bnvac/radio-thing/hardware/bom.csv

Refs | Value | Footprint | Variant | Note | Qty | DNP
BZ1 | 3V magnetic transducer ~3 kHz | Buzzer_Beeper:MagneticBuzzer_Kingstate_KCG0601 | DISP | external-drive coil (~8.5 ohm), 2-4 V, <=150 mA mean: drive with ~2.7-3 kHz square wave | 1
C1 | 1u | Capacitor_SMD:C_0603_1608Metric | BOTH |  | 1
C2,C4 | 4.7u | Capacitor_SMD:C_0603_1608Metric | BOTH |  | 2
C3,C8,C9,C16 | 22u | Capacitor_SMD:C_0805_2012Metric | BOTH |  | 4
C5,C7,C17,C18,C19,C21 | 100n | Capacitor_SMD:C_0402_1005Metric | BOTH | MAX17048 VDD bypass 0.1 uF per datasheet,VINA filter cap | 6
C6 | 10u | Capacitor_SMD:C_0805_2012Metric | BOTH |  | 1
C10 | 10u | Capacitor_SMD:C_0805_2012Metric | POD |  | 1
C11 | 22u | Capacitor_SMD:C_0805_2012Metric | POD | DS min ~5*L uF = 11 uF before DC-bias derating | 1
C12,C14,C24 | 100n | Capacitor_SMD:C_0402_1005Metric | POD |  | 3
C13 | 47u | Capacitor_SMD:C_1206_3216Metric | POD |  | 1
C15 | 1u | Capacitor_SMD:C_0402_1005Metric | BOTH | EN RC delay | 1
C20 | 220n | Capacitor_SMD:C_0402_1005Metric | BOTH | LIS2MDL C1 = 220 nF, low ESR, right at pins 5/6 (DS Table 2) | 1
C25 | 10u | Capacitor_SMD:C_0603_1608Metric | BOTH | LIS2MDL recommends 100 nF + 10 uF on Vdd | 1
D1 | BAT54 | Diode_SMD:D_SOD-123 | DISP | flyback across the coil | 1
D2 | RED | LED_SMD:LED_0603_1608Metric | BOTH |  | 1
D3 | GREEN | LED_SMD:LED_0603_1608Metric | BOTH |  | 1
D4 | BLUE | LED_SMD:LED_0603_1608Metric | BOTH |  | 1
F1 | 1.5A hold | Fuse:Fuse_1206_3216Metric | BOTH |  | 1
FB1 | 600R@100MHz 1A | Inductor_SMD:L_0805_2012Metric | POD | LC filter: keep boost ripple out of the radar | 1
J1 | USB-C | Connector_USB:USB_C_Receptacle_HRO_TYPE-C-31-M-12 | BOTH |  | 1
J2 | LiPo 1S | Connector_JST:JST_PH_S2B-PH-SM4-TB_1x02-1MP_P2.00mm_Horizontal | BOTH | CHECK battery lead polarity - vendors differ | 1
J3 | ST7796 3.5in SPI | Connector_PinSocket_2.54mm:PinSocket_1x14_P2.54mm_Vertical | DISP | lcdwiki MSP3525/MSP3526 (ST7796) pinout. VCC feeds the module's own 3.3 V LDO, so it takes switched VSYS (PWR_EN, after SW1) - fully off when switched off. Pins 10-13 = CTP (unused) | 1
J4 | RADAR HEAD | Connector_JST:JST_GH_SM10B-GHS-TB_1x10-1MP_P1.25mm_Horizontal | POD | Latching JST-GH; head ID resistor on head board to GND | 1
J5 | DEBUG UART | Connector_PinHeader_2.54mm:PinHeader_1x04_P2.54mm_Vertical | BOTH |  | 1
L1 | 2.2uH Isat>=2A low DCR | Inductor_SMD:L_Taiyo-Yuden_NR-40xx | BOTH | TPS6300x DS Table 1 uses 2.2 uH (VLF4012-2R2) | 1
L2 | 2.2uH 2A | Inductor_SMD:L_Taiyo-Yuden_NR-40xx | POD |  | 1
Q3 | 2N7002 | Package_TO_SOT_SMD:SOT-23 | DISP |  | 1
R1,R2 | 5.1k | Resistor_SMD:R_0402_1005Metric | BOTH | USB-C sink pull-down | 2
R3,R8,R10,R11,R22 | 10k | Resistor_SMD:R_0402_1005Metric | BOTH | /CHG open-drain pull-up,SA0 low -> I2C addr 0x6A,no NTC: fixed 10k = normal temp. Fit 10k NTC in cell instead if pack has one | 5
R4 | 1.78k | Resistor_SMD:R_0402_1005Metric | BOTH | ILIM = 1610/R ~= 0.9 A input limit (USB-C default 900 mA). BQ2407x DS SLUS810N eq.1 | 1
R5 | 46.4k | Resistor_SMD:R_0402_1005Metric | BOTH | fast-charge timer ~6.2 h, pre-charge ~37 min (DS 9.3.5.6) | 1
R6 | 3.0k | Resistor_SMD:R_0402_1005Metric | BOTH | termination = 10% of ICHG for any RISET (0.03*R_ITERM/R_ISET); 15k would stop at 50% | 1
R7 | 2k | Resistor_SMD:R_0402_1005Metric | BOTH | ISET = 890/R ~= 445 mA (POD 500 mAh). DISPLAY build: 1k -> ~890 mA for 2000 mAh | 1
R9 | 100k | Resistor_SMD:R_0402_1005Metric | POD | head rail off until firmware enables it | 1
R12,R13 | 4.7k | Resistor_SMD:R_0402_1005Metric | BOTH |  | 2
R14 | 10k | Resistor_SMD:R_0402_1005Metric | DISP | keep the module's SD card deselected (it shares MISO) | 1
R15 | 100 | Resistor_SMD:R_0402_1005Metric | DISP | LED pin is a logic input (onboard BSS138 + 10k pull-up): high/open = backlight on, low = off; PWM ok | 1
R17 | 100k | Resistor_SMD:R_0402_1005Metric | DISP |  | 1
R18,R19,R20 | 1k | Resistor_SMD:R_0402_1005Metric | BOTH |  | 3
R21 | 10k | Resistor_SMD:R_0402_1005Metric | POD |  | 1
R23 | 15 | Resistor_SMD:R_0402_1005Metric | DISP | limits coil current to ~140 mA peak / ~70 mA mean at 50% duty | 1
R24 | 100 | Resistor_SMD:R_0402_1005Metric | BOTH | VINA RC filter per TPS6300x reference design | 1
R26,R27,R28,R29 | 100 | Resistor_SMD:R_0402_1005Metric | POD | series R: limits back-powering/ESD on the detachable head | 4
SW1 | PWR | Button_Switch_SMD:SW_SPDT_PCM12 | BOTH | off = 3V3 rail off; battery still charges | 1
SW2 | RESET | Button_Switch_SMD:SW_Push_SPST_NO_Alps_SKRK | BOTH |  | 1
SW3 | BOOT | Button_Switch_SMD:SW_Push_SPST_NO_Alps_SKRK | BOTH |  | 1
SW4 | UP | Button_Switch_THT:SW_PUSH-12mm | DISP | short = up/zoom in, hold = cycle mode | 1
SW5 | DOWN | Button_Switch_THT:SW_PUSH-12mm | DISP | short = down/zoom out | 1
SW6 | OK | Button_Switch_THT:SW_PUSH-12mm | BOTH | Fitted on both builds; pod's only button; deep-sleep wake. Hold 1.5 s = back, 3 s = sleep | 1
U1 | USBLC6-2SC6 | Package_TO_SOT_SMD:SOT-23-6 | BOTH |  | 1
U2 | BQ24074RGT | Package_DFN_QFN:VQFN-16-1EP_3x3mm_P0.5mm_EP1.6x1.6mm | BOTH | EN2=1, EN1=0 -> input current limit set by R_ILIM; /CE=0 charge enabled | 1
U3 | MAX17048G+T10 | Package_DFN_QFN:TDFN-8-1EP_2x2mm_P0.5mm_EP0.8x1.2mm | BOTH | CTG and QSTRT tied to GND per datasheet; ALRT unused (polled) | 1
U4 | TPS63001 | Package_SON:Texas_DRC0010J_ThermalVias | BOTH | PS/SYNC high = forced PWM (lower, predictable ripple for the radar) | 1
U5 | TPS61202 | Package_SON:Texas_S-PVSON-N10_ThermalVias | POD | fixed 5 V; UVLO tied to VIN (unused); PS high (verify PS polarity in datasheet) | 1
U6 | ESP32-S3-WROOM-1U-N8R8 | RF_Module:ESP32-S3-WROOM-1U | BOTH | -1U variant: U.FL antenna connector -> SMA bulkhead pigtail. IO35-37 used by octal PSRAM | 1
U7 | ISM330DHCX | Package_LGA:LGA-14_3x2.5mm_P0.5mm_LayoutBorder3x4y | BOTH | I2C addr 0x6A (SA0=0). Aux SDx/SCx tied to GND when unused (verify) | 1
U8 | LIS2MDL | Package_LGA:LGA-12_2x2mm_P0.5mm | BOTH | I2C addr 0x1E | 1
