bnvac/radio-thing/enclosure/stl/radio_thing_front.stl

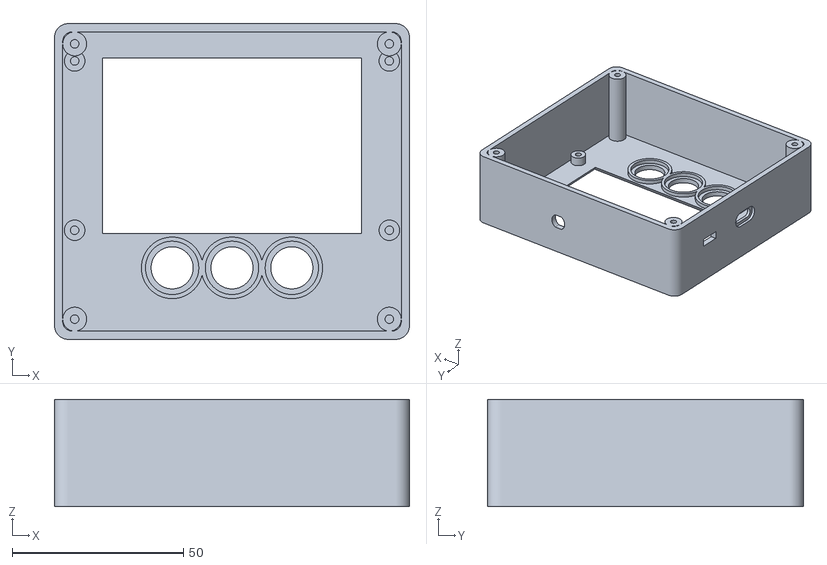
[picture p8: CAD file, 2026-10-24]
enclosure/stl/radio_thing_front.stl
103.8 x 92.3 x 31.3
