bnvac/radio-thing/enclosure/stl/radio_thing_caps.stl

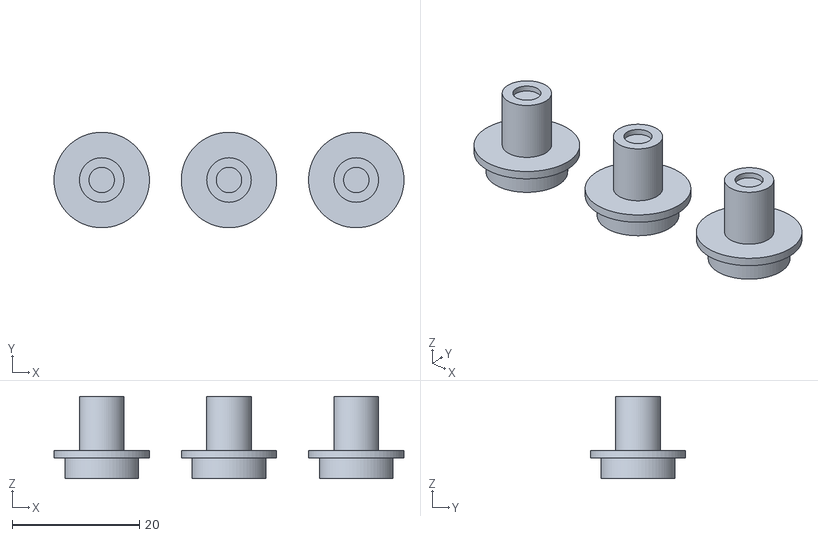
[picture p9: CAD file, 2026-10-24]
enclosure/stl/radio_thing_caps.stl
55.0 x 15.0 x 12.9
