bnvac/radio-thing/enclosure/stl/radio_thing_lid.stl

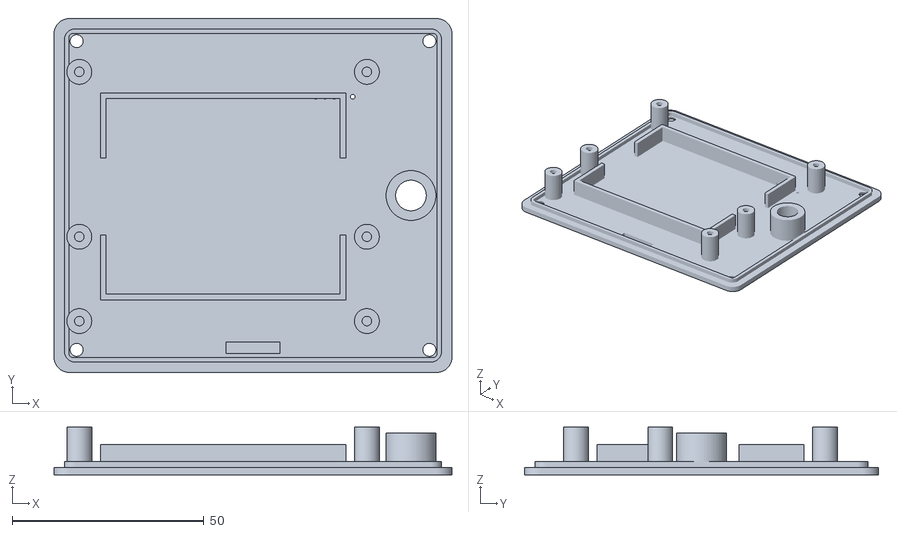
[picture p10: CAD file, 2026-10-24]
enclosure/stl/radio_thing_lid.stl
103.8 x 92.3 x 12.5
