bnvac/radio-thing/hardware/radio-thing-schematic.pdf

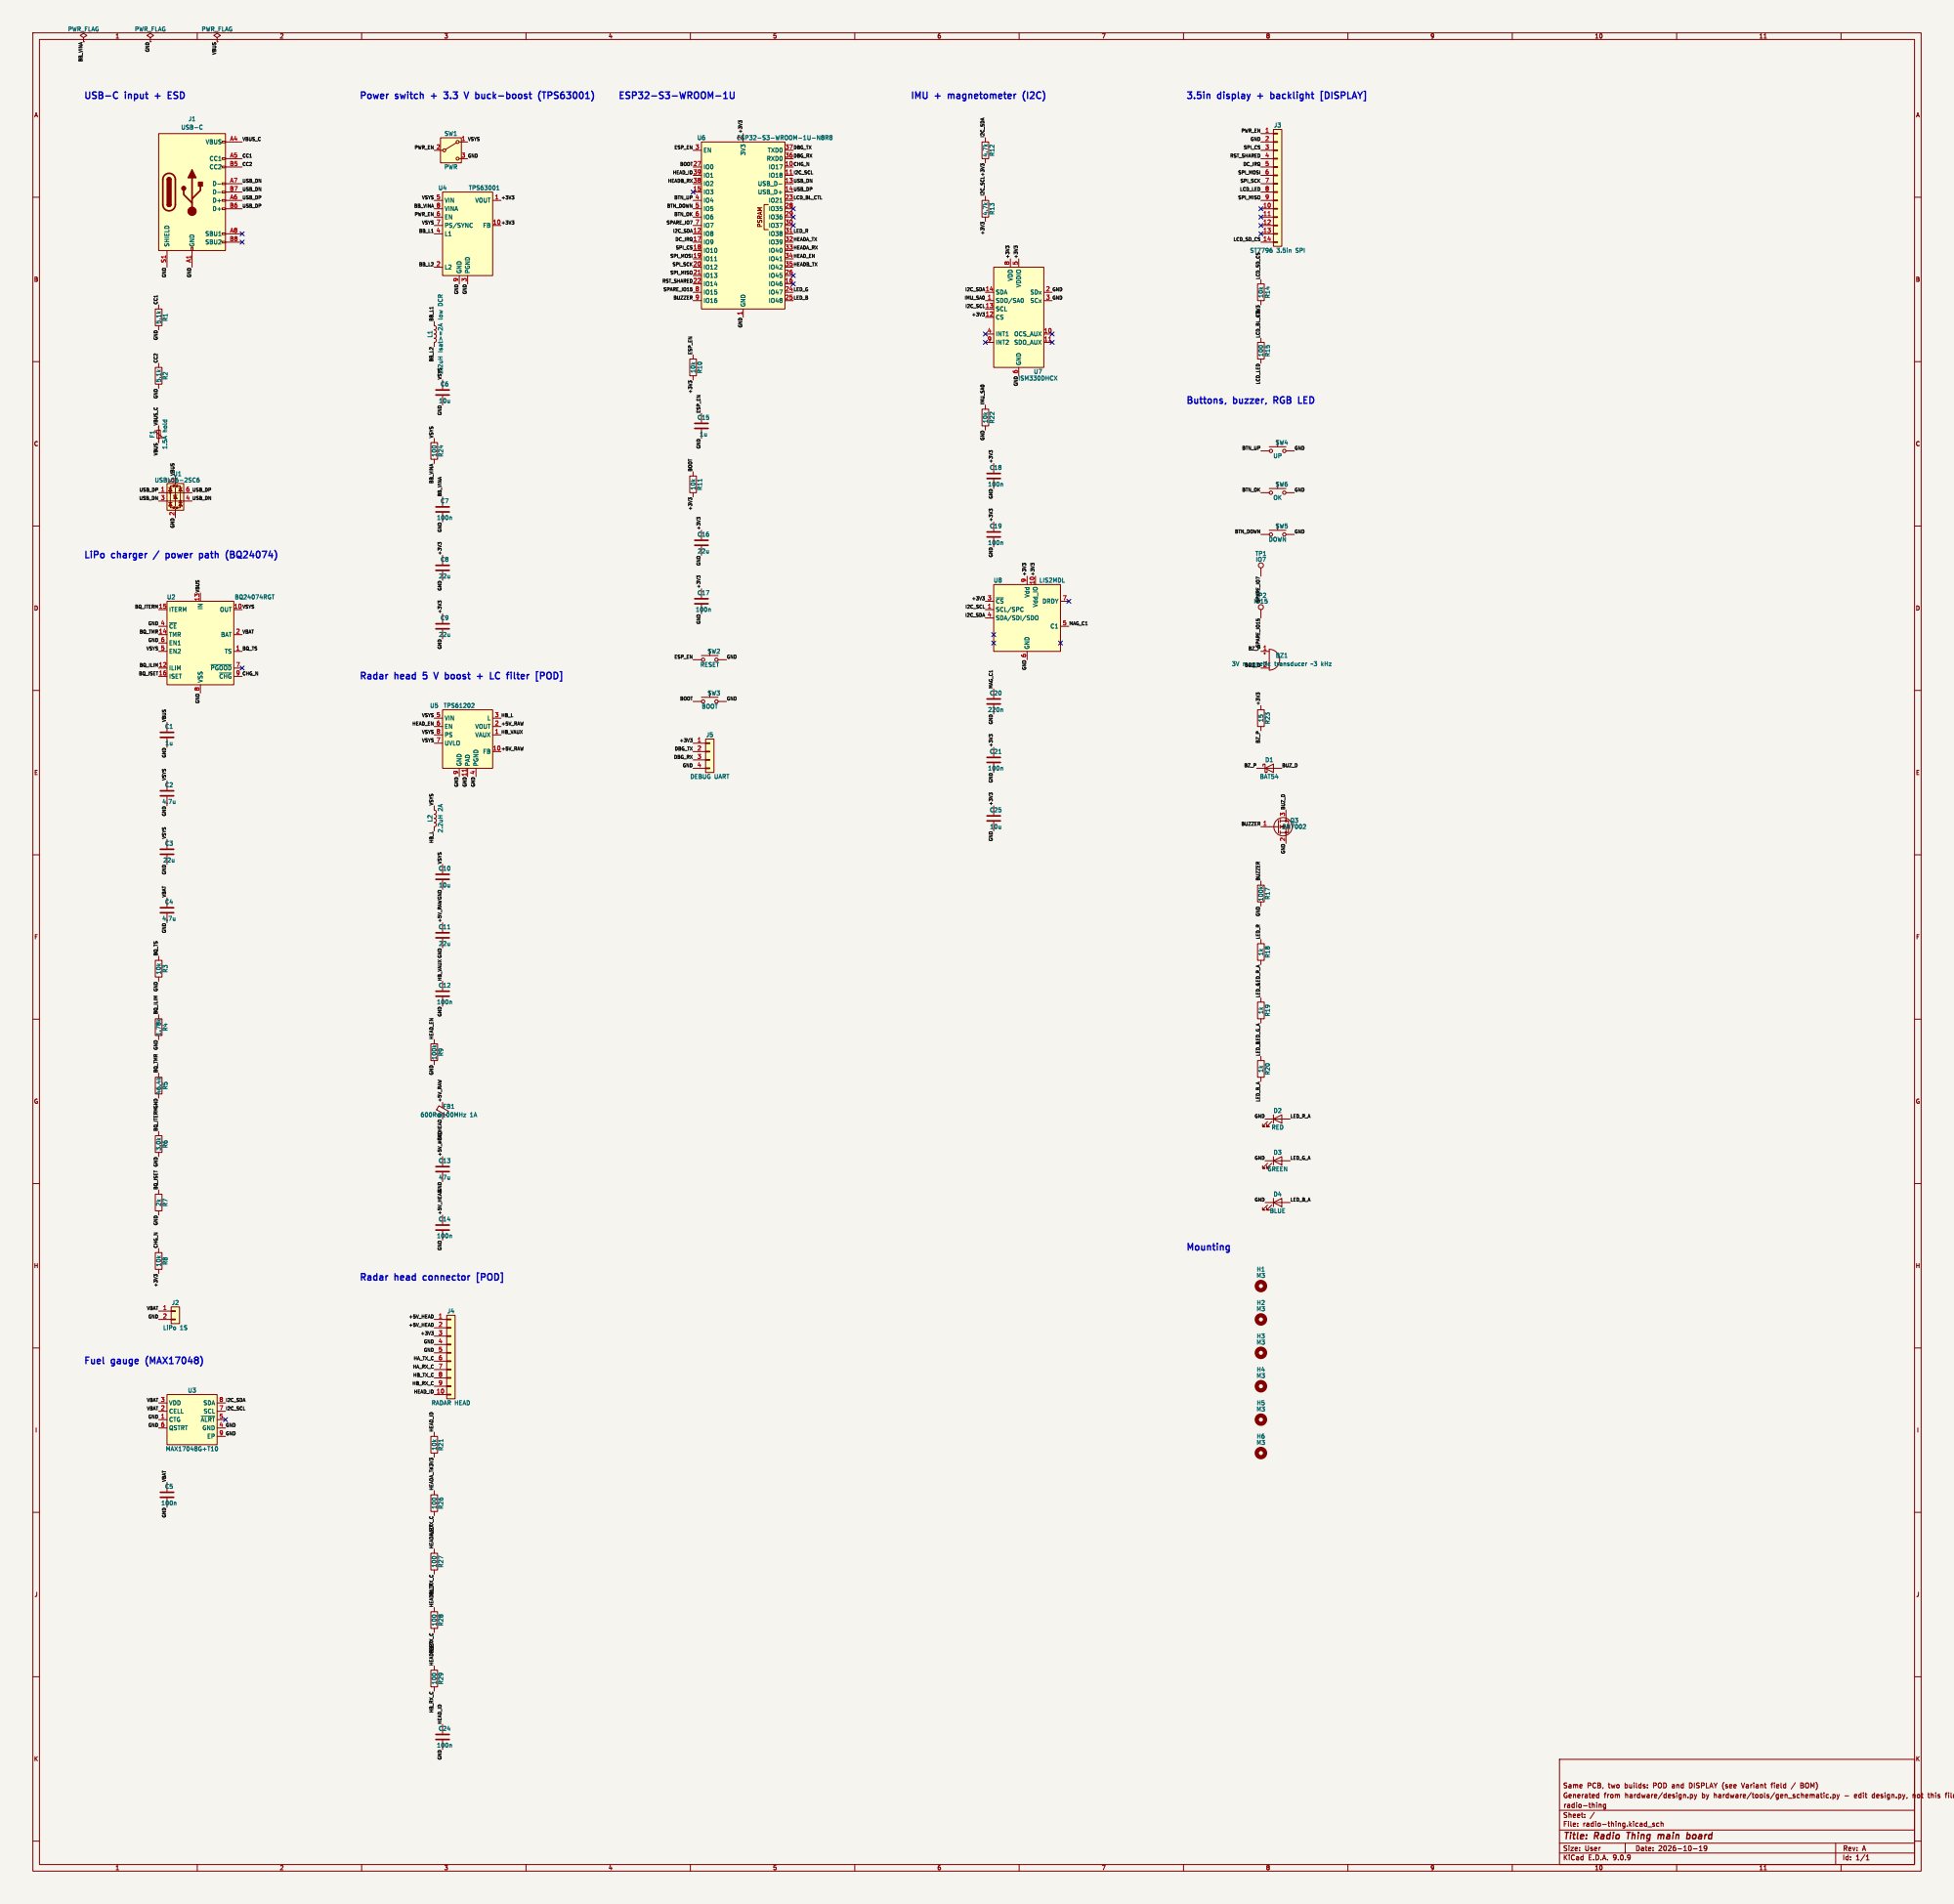
[picture p11: page 1]

10u L1 2.2uH Isat>=2A low DCR VIN 5 VINA 8 EN 6 PS/SYNC 7
VSYS
BB_VINA
PWR_EN

SDA 14 SDO/SA0 1 SCL 13 CS 12

Buttons, buzzer, RGB LED

LiPo charger / power path (BQ24074)

Radar head 5 V boost + LC filter [POD]

Radar head connector [POD]

Id: 1/1 Title: Radio Thing main board
