bnvac/radio-thing/hardware/radio-thing.kicad_pcb

## KiCad design hardware/radio-thing.kicad_pcb (2026-10-24)

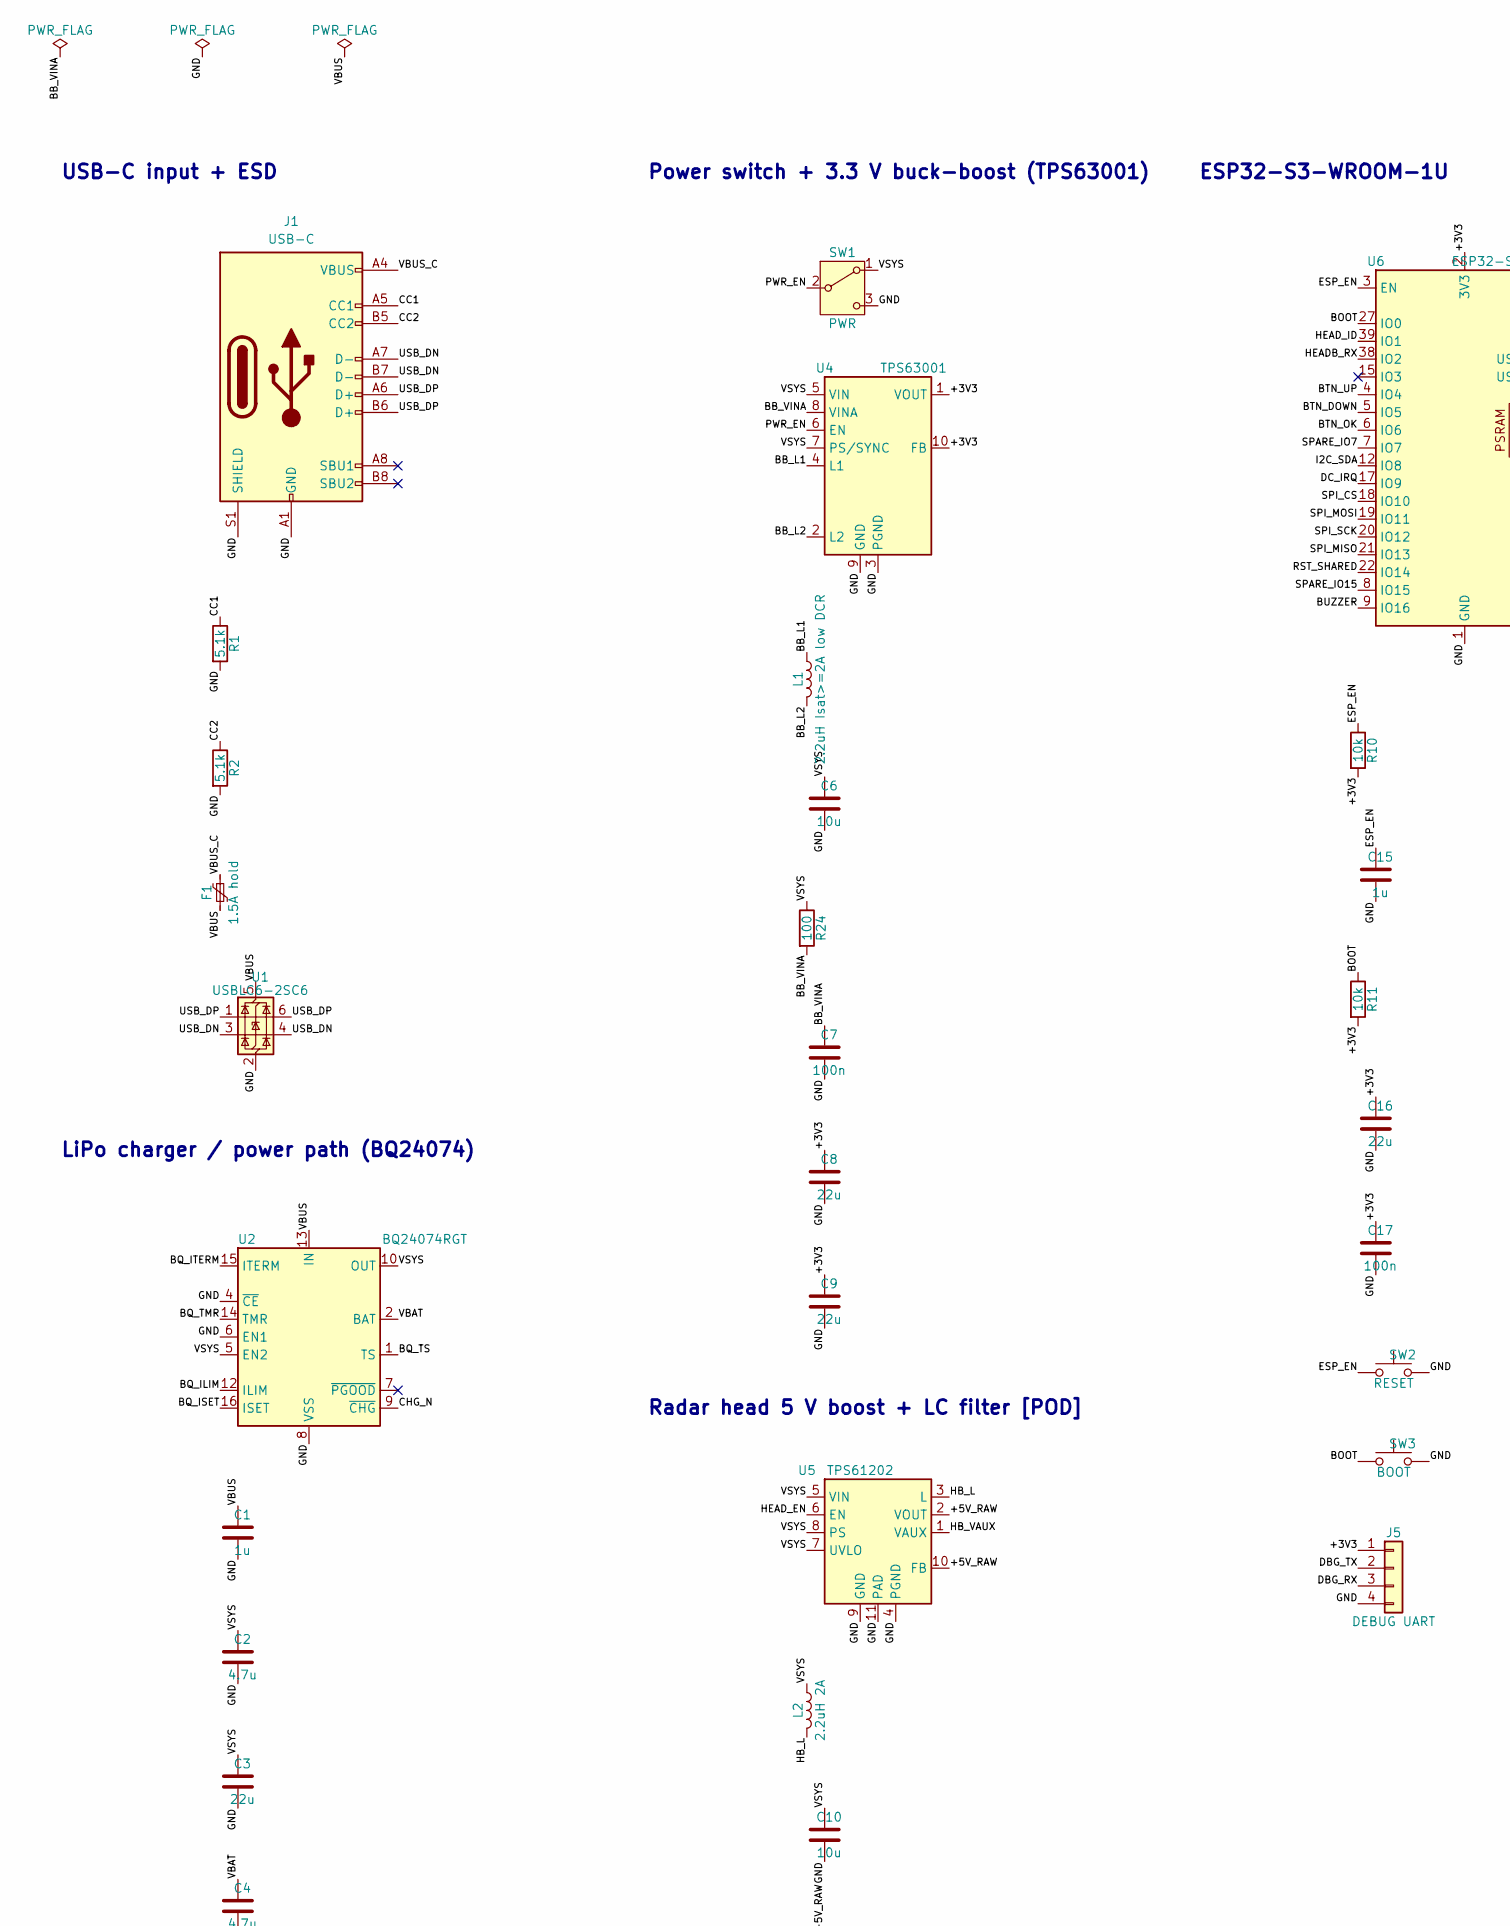
[picture p12: schematic radio-thing.kicad_sch, Radio Thing main board, part in row 1, column 1]

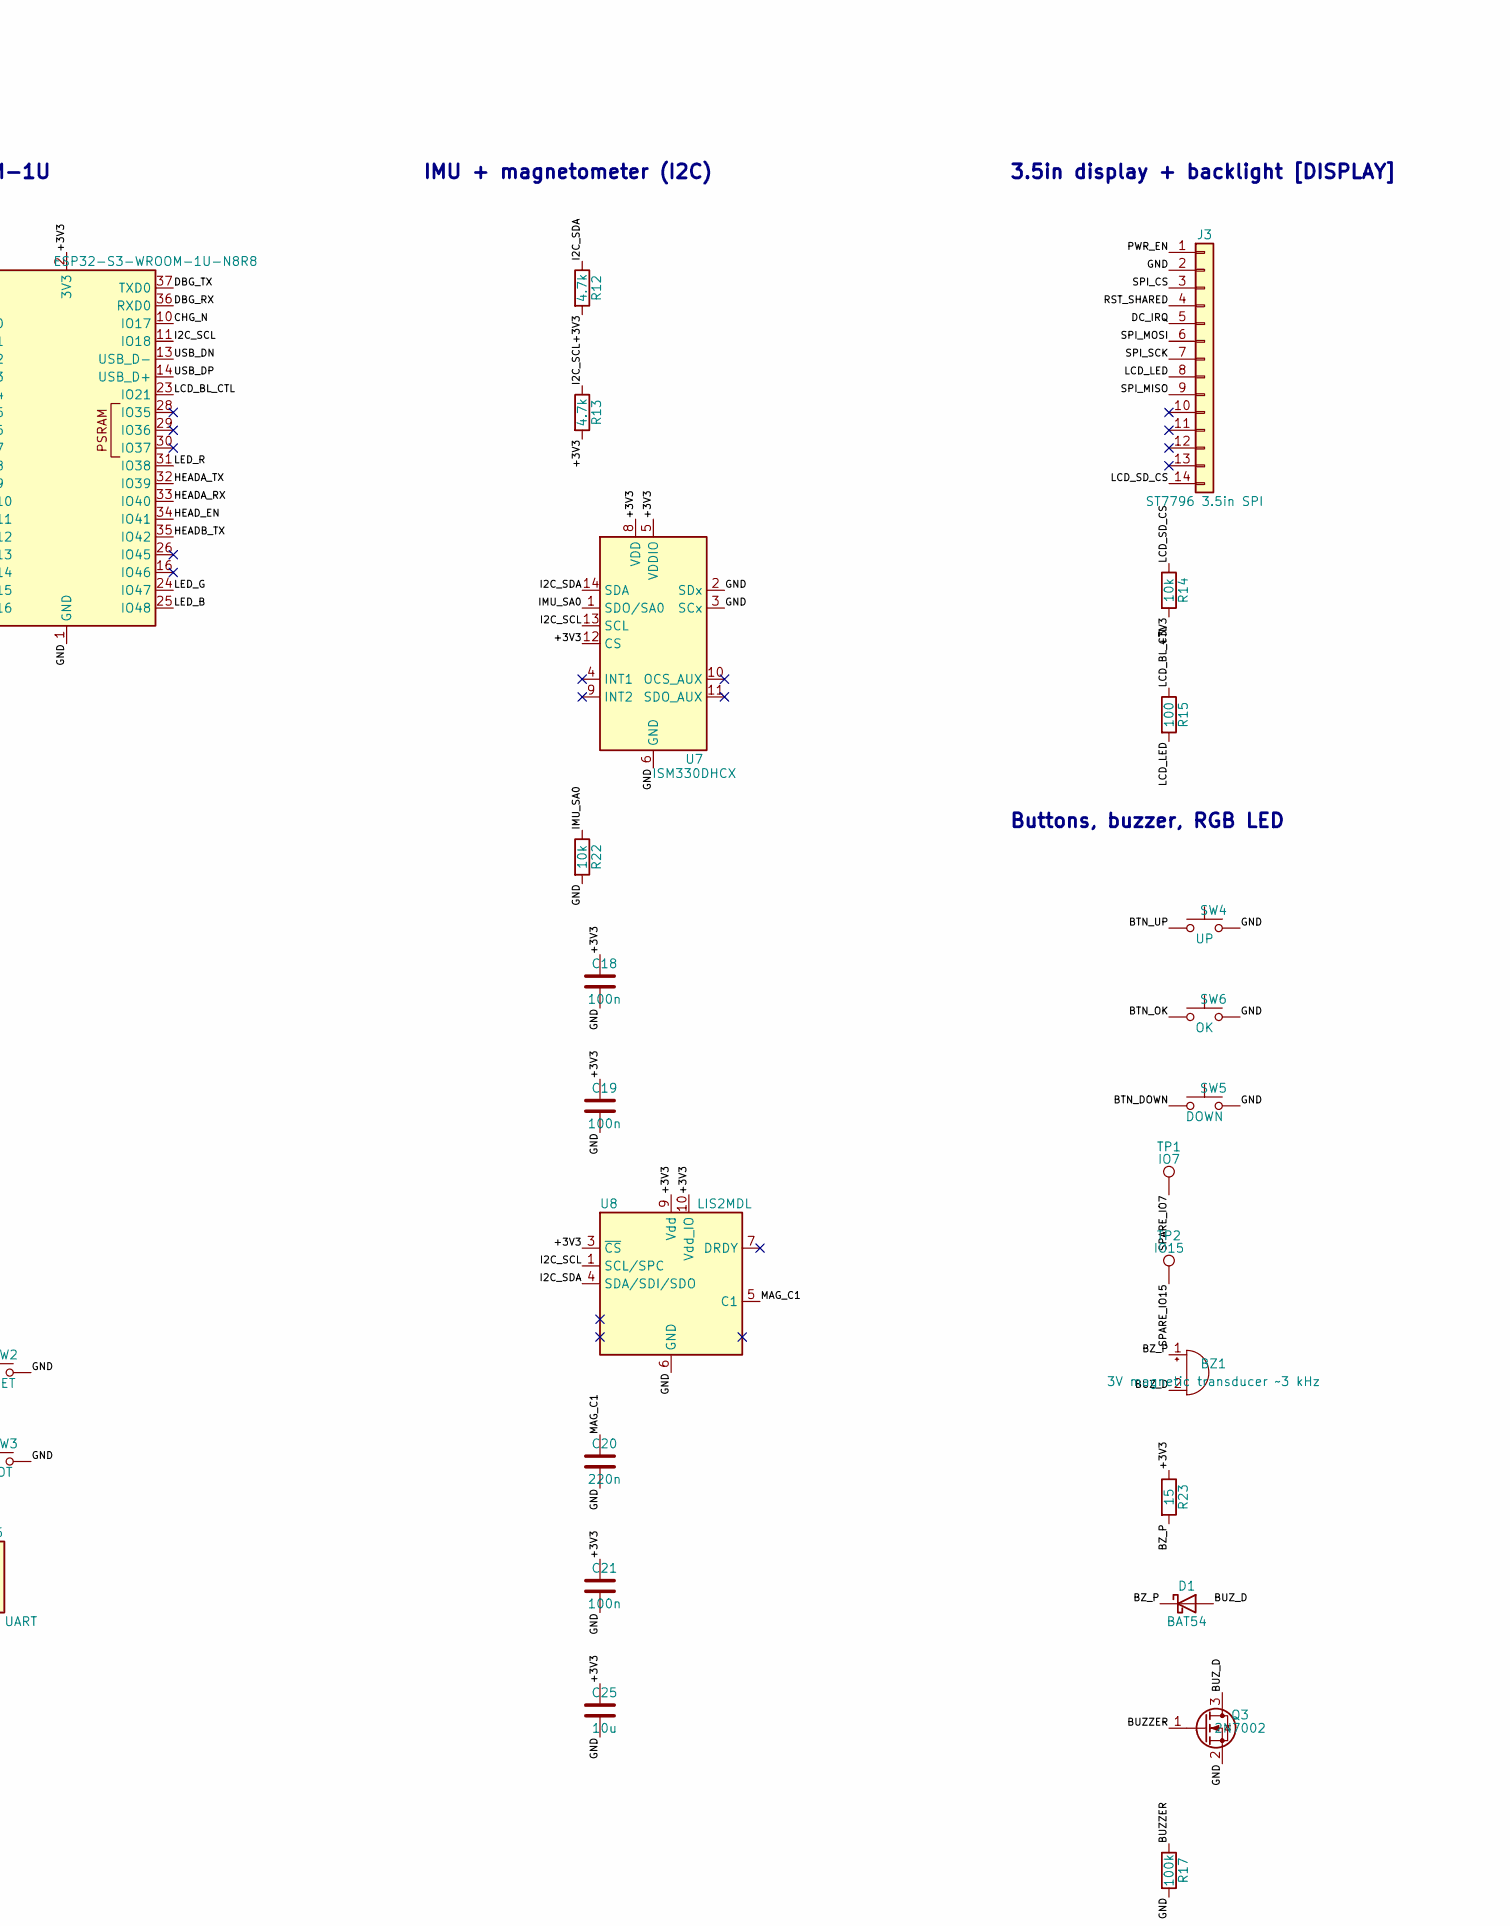
[picture p13: schematic radio-thing.kicad_sch, Radio Thing main board, part in row 1, column 2]

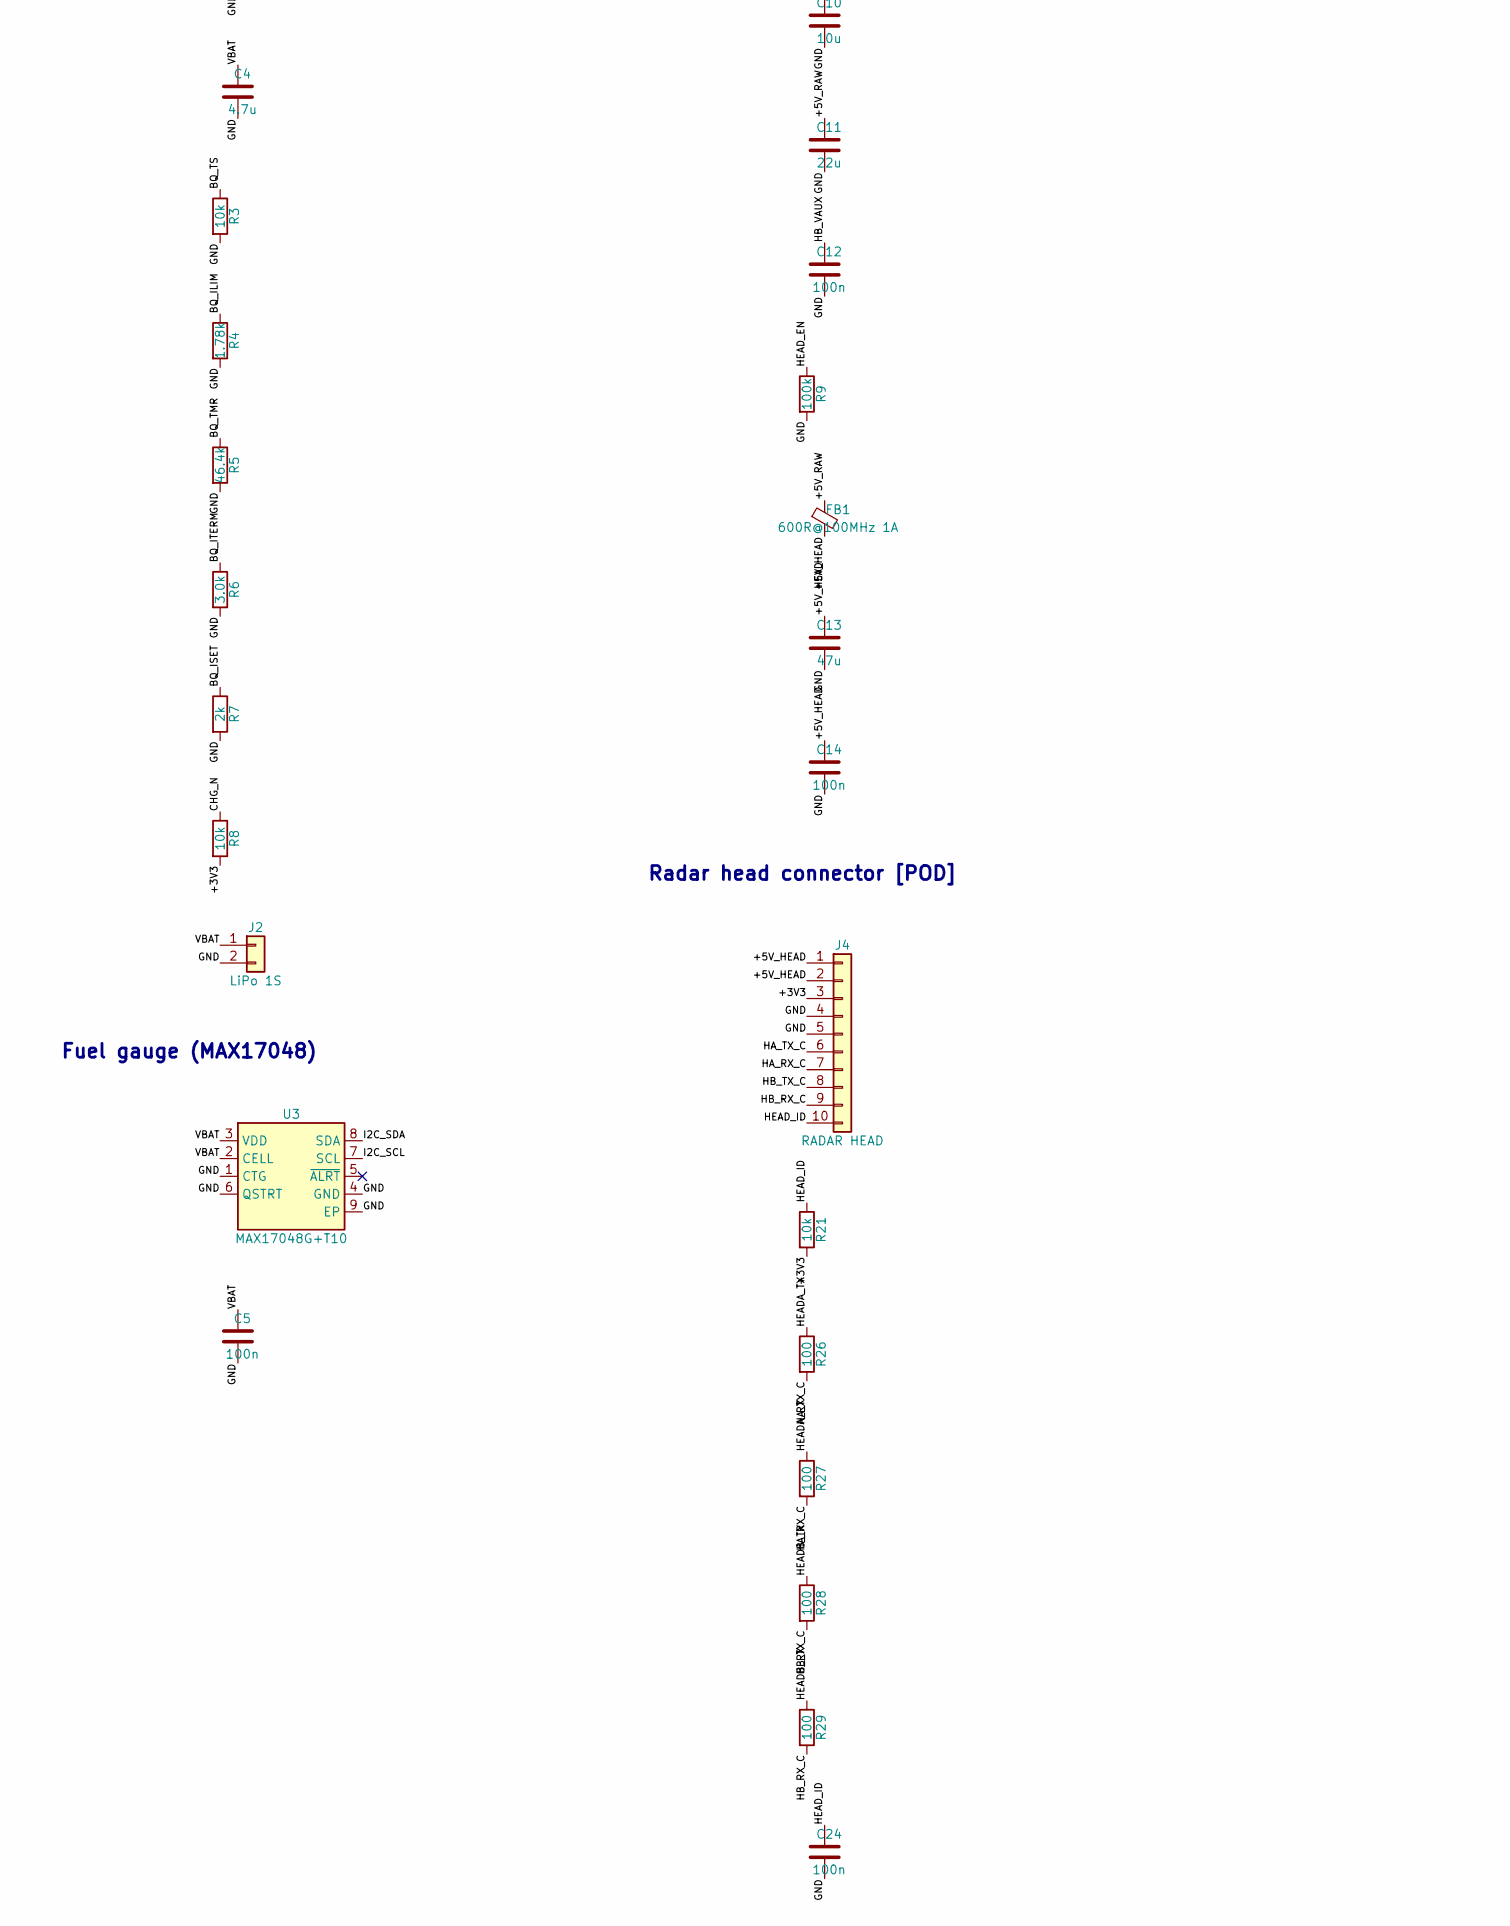
[picture p14: schematic radio-thing.kicad_sch, Radio Thing main board, part in row 2, column 1]

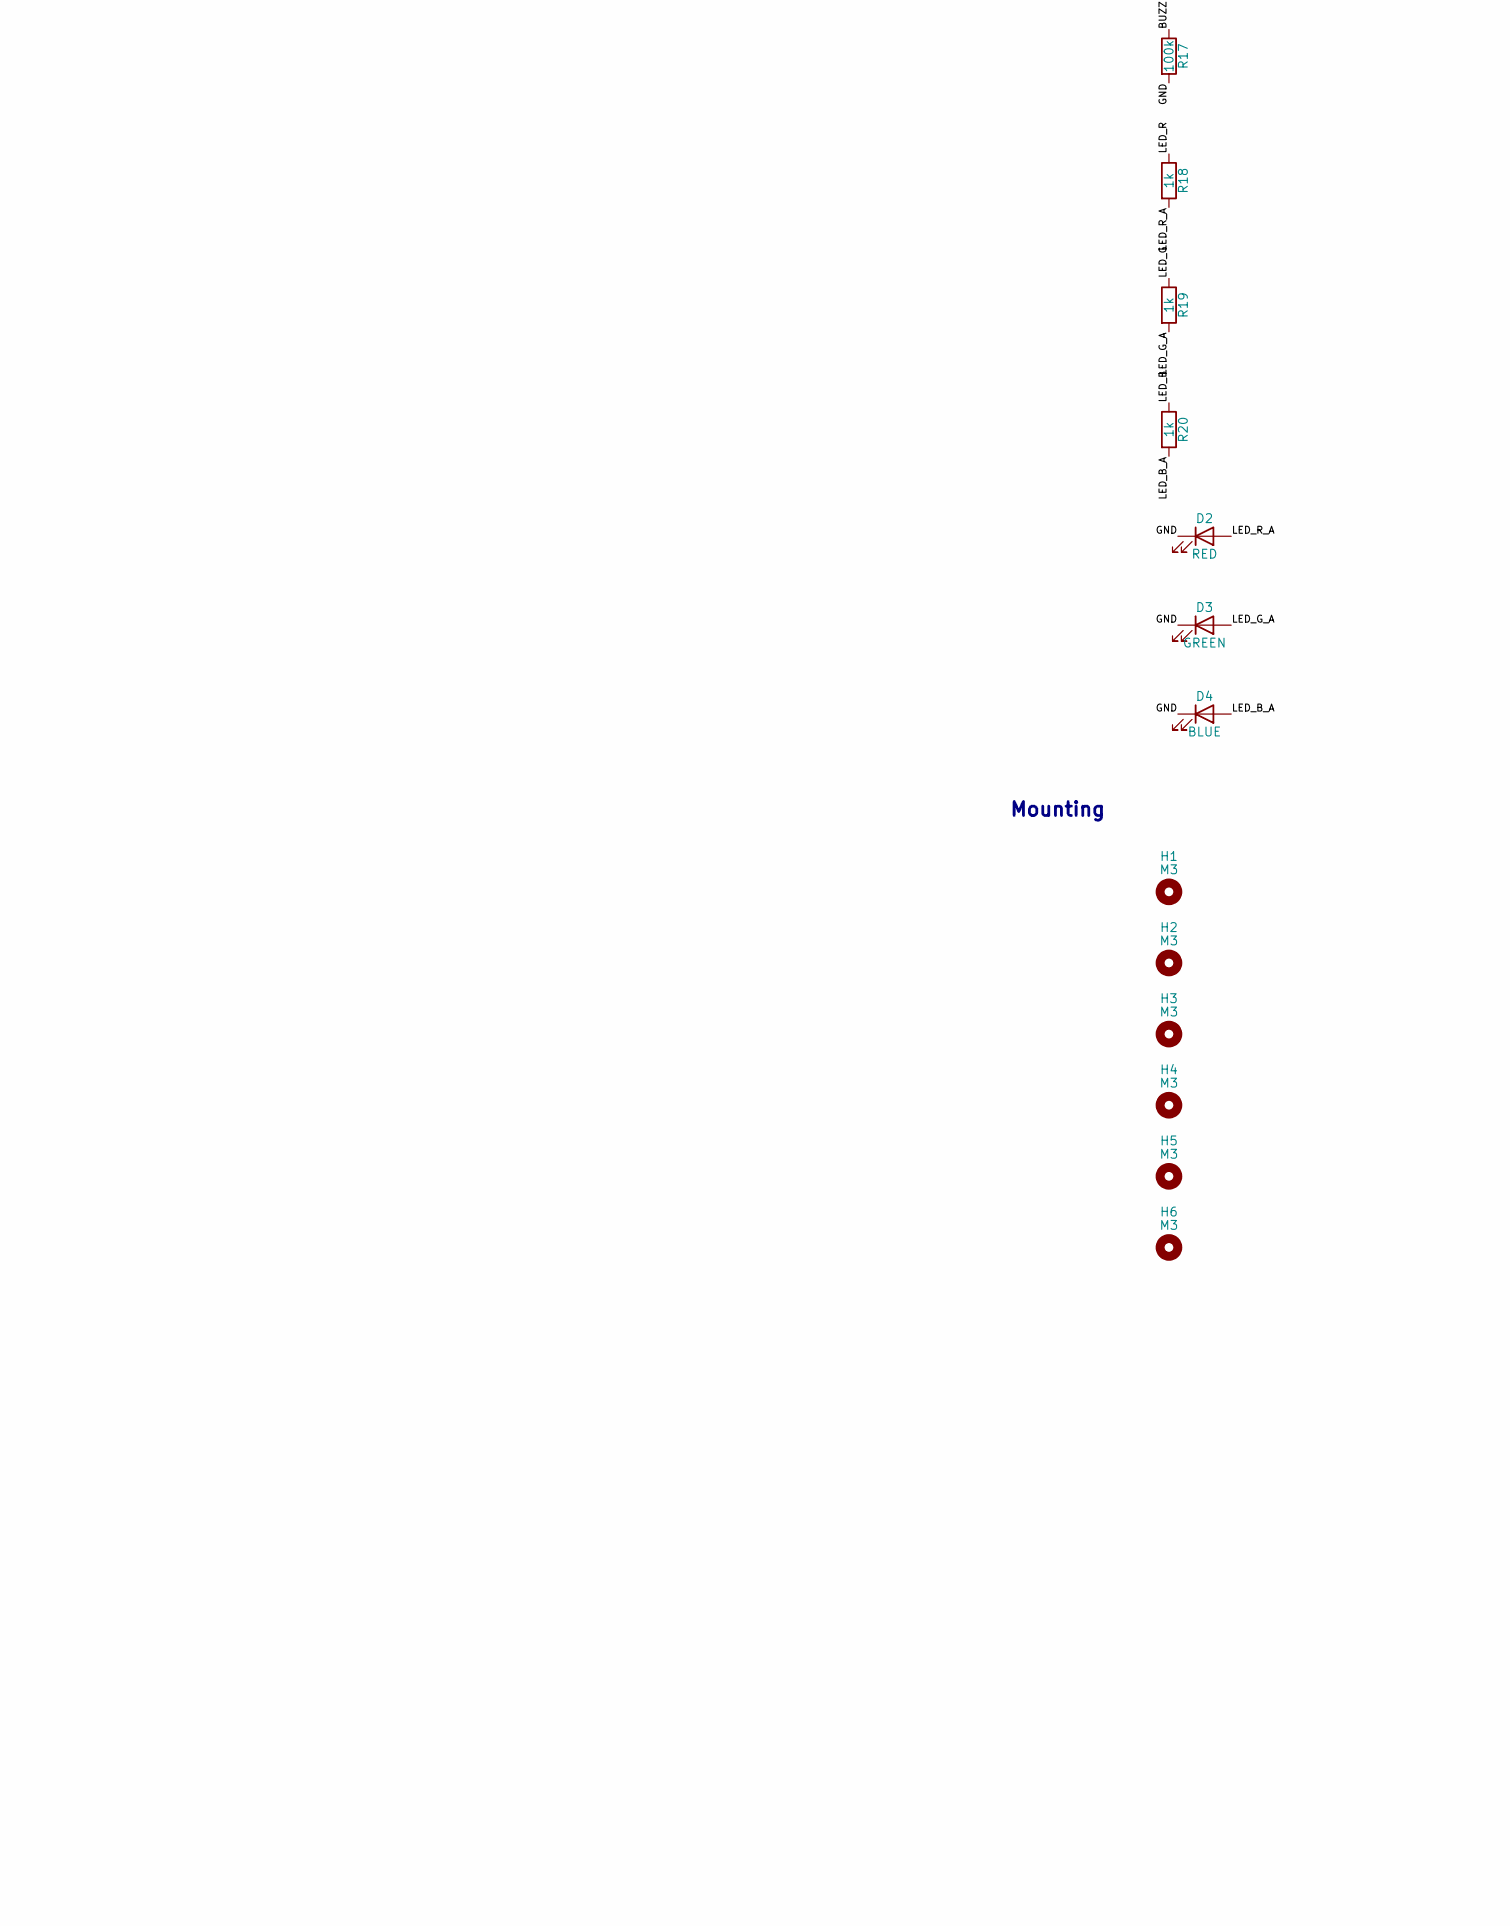
[picture p15: schematic radio-thing.kicad_sch, Radio Thing main board, part in row 2, column 2]

Parts:
BZ1: 3V magnetic transducer ~3 kHz; MagneticBuzzer_Kingstate_KCG0601
C1: 1u; C_0603_1608Metric
C2, C4: 4.7u; C_0603_1608Metric
C3, C8, C9, C11, C16: 22u; C_0805_2012Metric
C5, C7, C12, C14, C17, C18, C19, C21, C24: 100n; C_0402_1005Metric
C6, C10: 10u; C_0805_2012Metric
C13: 47u; C_1206_3216Metric
C15: 1u; C_0402_1005Metric
C20: 220n; C_0402_1005Metric
C25: 10u; C_0603_1608Metric
D1: BAT54; D_SOD-123
D2: RED; LED_0603_1608Metric
D3: GREEN; LED_0603_1608Metric
D4: BLUE; LED_0603_1608Metric
F1: 1.5A hold; Fuse_1206_3216Metric
FB1: 600R@100MHz 1A; L_0805_2012Metric
H1, H2, H3, H4, H5, H6: M3; MountingHole_3.2mm_M3
J1: USB-C; USB_C_Receptacle_HRO_TYPE-C-31-M-12
J2: LiPo 1S; JST_PH_S2B-PH-SM4-TB_1x02-1MP_P2.00mm_Horizontal
J3: ST7796 3.5in SPI; PinSocket_1x14_P2.54mm_Vertical
J4: RADAR HEAD; JST_GH_SM10B-GHS-TB_1x10-1MP_P1.25mm_Horizontal
J5: DEBUG UART; PinHeader_1x04_P2.54mm_Vertical
L1: 2.2uH Isat>=2A low DCR; L_Taiyo-Yuden_NR-40xx
L2: 2.2uH 2A; L_Taiyo-Yuden_NR-40xx
Q3: 2N7002; SOT-23
R1, R2: 5.1k; R_0402_1005Metric
R3, R8, R10, R11, R14, R21, R22: 10k; R_0402_1005Metric
R4: 1.78k; R_0402_1005Metric
R5: 46.4k; R_0402_1005Metric
R6: 3.0k; R_0402_1005Metric
R7: 2k; R_0402_1005Metric
R9, R17: 100k; R_0402_1005Metric
R12, R13: 4.7k; R_0402_1005Metric
R15, R24, R26, R27, R28, R29: 100; R_0402_1005Metric
R18, R19, R20: 1k; R_0402_1005Metric
R23: 15; R_0402_1005Metric
SW1: PWR; SW_SPDT_PCM12
SW2: RESET; SW_Push_SPST_NO_Alps_SKRK
SW3: BOOT; SW_Push_SPST_NO_Alps_SKRK
SW4: UP; SW_PUSH-12mm
SW5: DOWN; SW_PUSH-12mm
SW6: OK; SW_PUSH-12mm
TP1: IO7; TestPoint_Pad_D1.5mm
TP2: IO15; TestPoint_Pad_D1.5mm
U1: USBLC6-2SC6; SOT-23-6
U2: BQ24074RGT; VQFN-16-1EP_3x3mm_P0.5mm_EP1.6x1.6mm
U3: MAX17048G+T10; TDFN-8-1EP_2x2mm_P0.5mm_EP0.8x1.2mm
U4: TPS63001; Texas_DRC0010J_ThermalVias
U5: TPS61202; Texas_S-PVSON-N10_ThermalVias
U6: ESP32-S3-WROOM-1U-N8R8; ESP32-S3-WROOM-1U
U7: ISM330DHCX; LGA-14_3x2.5mm_P0.5mm_LayoutBorder3x4y
U8: LIS2MDL; LGA-12_2x2mm_P0.5mm

Connections:
/+3V3: C8.1, C9.1, C16.1, C17.1, C18.1, C19.1, C21.1, C25.1, J4.3, J5.1, R8.2, R10.2, R11.2, R12.2, R13.2, R14.2, R21.2, R23.1, U4.1 (VOUT), U4.10 (FB), U6.2 (3V3), U7.5 (VDDIO), U7.8 (VDD), U7.12 (CS), U8.3 (~CS), U8.9 (Vdd), U8.10 (Vdd_IO)
/+5V_HEAD: C13.1, C14.1, FB1.2, J4.1, J4.2
/+5V_RAW: C11.1, FB1.1, U5.2 (VOUT), U5.10 (FB)
/BB_L1: L1.1, U4.4 (L1)
/BB_L2: L1.2, U4.2 (L2)
/BB_VINA: C7.1, R24.2, U4.8 (VINA)
/BOOT: R11.1, SW3.1, U6.27 (IO0)
/BQ_ILIM: R4.1, U2.12 (ILIM)
/BQ_ISET: R7.1, U2.16 (ISET)
/BQ_ITERM: R6.1, U2.15 (ITERM)
/BQ_TMR: R5.1, U2.14 (TMR)
/BQ_TS: R3.1, U2.1 (TS)
/BTN_DOWN: SW5.1, U6.5 (IO5)
/BTN_OK: SW6.1, U6.6 (IO6)
/BTN_UP: SW4.1, U6.4 (IO4)
/BUZZER: Q3.1 (G), R17.1, U6.9 (IO16)
/BUZ_D: BZ1.2 (-), D1.2 (A), Q3.3 (D)
/BZ_P: BZ1.1 (+), D1.1 (K), R23.2
/CC1: J1.A5 (CC1), R1.1
/CC2: J1.B5 (CC2), R2.1
/CHG_N: R8.1, U2.9 (~CHG), U6.10 (IO17)
/DBG_RX: J5.3, U6.36 (RXD0)
/DBG_TX: J5.2, U6.37 (TXD0)
/DC_IRQ: J3.5, U6.17 (IO9)
/ESP_EN: C15.1, R10.1, SW2.1, U6.3 (EN)
/GND: C1.2, C2.2, C3.2, C4.2, C5.2, C6.2, C7.2, C8.2, C9.2, C10.2, C11.2, C12.2, C13.2, C14.2, C15.2, C16.2, C17.2, C18.2, C19.2, C20.2, C21.2, C24.2, C25.2, D2.1 (K), D3.1 (K), D4.1 (K), J1.A1 (GND), J1.A12 (GND), J1.B1 (GND), J1.B12 (GND), J1.S1 (SHIELD), J2.2, J3.2, J4.4, J4.5, J5.4, Q3.2 (S), R1.2, R2.2, R3.2, R4.2, R5.2, R6.2, R7.2, R9.2, R17.2, R22.2, SW1.3 (C), SW2.2, SW3.2, SW4.2, SW5.2, SW6.2, U1.2 (GND), U2.4 (~CE), U2.6 (EN1), U2.8 (VSS), U2.17 (VSS), U3.1 (CTG), U3.4 (GND), U3.6 (QSTRT), U3.9 (EP), U4.3 (PGND), U4.9 (GND), U4.11 (PGND), U5.4 (PGND), U5.9 (GND), U5.11 (PAD), U6.1 (GND), U6.40 (GND), U6.41 (GND), U7.2 (SDx), U7.3 (SCx), U7.6 (GND), U7.7 (GND), U8.6 (GND), U8.8 (GND)
/HA_RX_C: J4.7, R27.2
/HA_TX_C: J4.6, R26.2
/HB_L: L2.2, U5.3 (L)
/HB_RX_C: J4.9, R29.2
/HB_TX_C: J4.8, R28.2
/HB_VAUX: C12.1, U5.1 (VAUX)
/HEADA_RX: R27.1, U6.33 (IO40)
/HEADA_TX: R26.1, U6.32 (IO39)
/HEADB_RX: R29.1, U6.38 (IO2)
/HEADB_TX: R28.1, U6.35 (IO42)
/HEAD_EN: R9.1, U5.6 (EN), U6.34 (IO41)
/HEAD_ID: C24.1, J4.10, R21.1, U6.39 (IO1)
/I2C_SCL: R13.1, U3.7 (SCL), U6.11 (IO18), U7.13 (SCL), U8.1 (SCL/SPC)
/I2C_SDA: R12.1, U3.8 (SDA), U6.12 (IO8), U7.14 (SDA), U8.4 (SDA/SDI/SDO)
/IMU_SA0: R22.1, U7.1 (SDO/SA0)
/LCD_BL_CTL: R15.1, U6.23 (IO21)
/LCD_LED: J3.8, R15.2
/LCD_SD_CS: J3.14, R14.1
/LED_B: R20.1, U6.25 (IO48)
/LED_B_A: D4.2 (A), R20.2
/LED_G: R19.1, U6.24 (IO47)
/LED_G_A: D3.2 (A), R19.2
/LED_R: R18.1, U6.31 (IO38)
/LED_R_A: D2.2 (A), R18.2
/MAG_C1: C20.1, U8.5 (C1)
/PWR_EN: J3.1, SW1.2 (B), U4.6 (EN)
/RST_SHARED: J3.4, U6.22 (IO14)
/SPARE_IO7: TP1.1, U6.7 (IO7)
/SPARE_IO15: TP2.1, U6.8 (IO15)
/SPI_CS: J3.3, U6.18 (IO10)
/SPI_MISO: J3.9, U6.21 (IO13)
/SPI_MOSI: J3.6, U6.19 (IO11)
/SPI_SCK: J3.7, U6.20 (IO12)
/USB_DN: J1.A7 (D-), J1.B7 (D-), U1.3 (I/O2), U1.4 (I/O2), U6.13 (USB_D-)
/USB_DP: J1.A6 (D+), J1.B6 (D+), U1.1 (I/O1), U1.6 (I/O1), U6.14 (USB_D+)
/VBAT: C4.1, C5.1, J2.1, U2.2 (BAT), U2.3 (BAT), U3.2 (CELL), U3.3 (VDD)
/VBUS: C1.1, F1.2, U1.5 (VBUS), U2.13 (IN)
/VBUS_C: F1.1, J1.A4 (VBUS), J1.A9 (VBUS), J1.B4 (VBUS), J1.B9 (VBUS)
/VSYS: C2.1, C3.1, C6.1, C10.1, L2.1, R24.1, SW1.1 (A), U2.5 (EN2), U2.10 (OUT), U2.11 (OUT), U4.5 (VIN), U4.7 (PS/SYNC), U5.5 (VIN), U5.7 (UVLO), U5.8 (PS)

Notes on the sheet:
USB-C input + ESD
LiPo charger / power path (BQ24074)
Fuel gauge (MAX17048)
Power switch + 3.3 V buck-boost (TPS63001)
Radar head 5 V boost + LC filter [POD]
Radar head connector [POD]
ESP32-S3-WROOM-1U
IMU + magnetometer (I2C)
3.5in display + backlight [DISPLAY]
Buttons, buzzer, RGB LED
Mounting

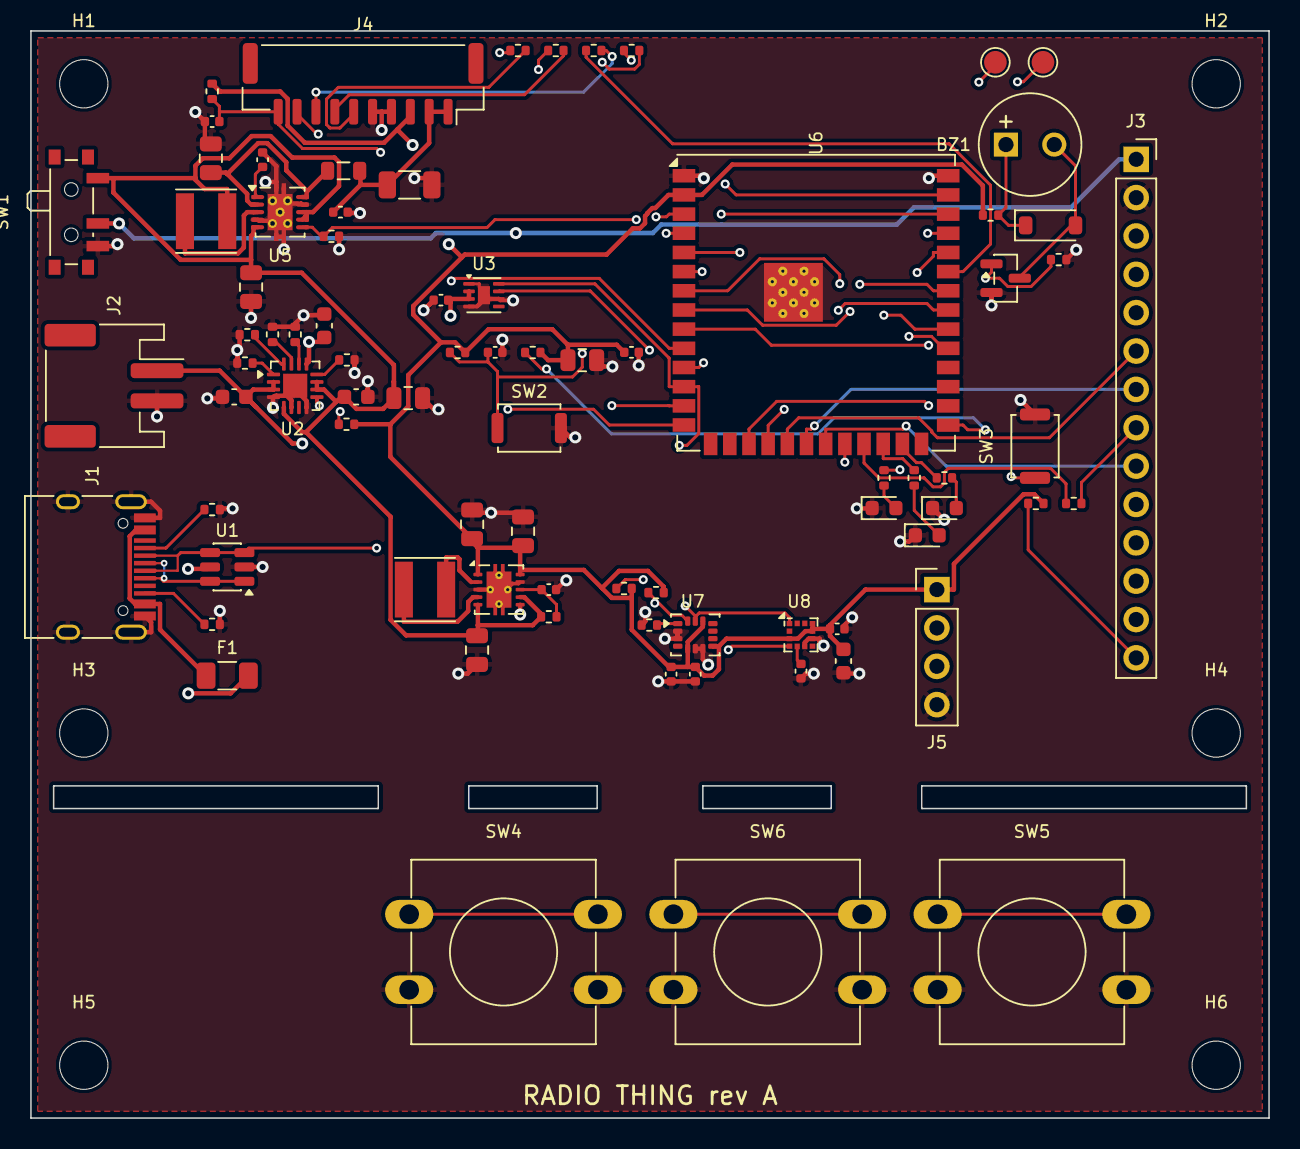
[picture p16: board radio-thing.kicad_pcb from above]

Board: 4 copper layers, 82.0 x 72.0 mm, 87 parts (0 on the bottom side), 65 nets.
