bnvac/radio-thing/(commit log)

2026-10-19 Scope: unified dual-radar handheld/mountable design
    Claude-Session: https://claude.ai/code/session_01Qyypna6NiNd8puVy66YruE
2026-10-19 Scope: pod/display split, drone/vehicle/adhesive mounting, accuracy plan
    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
2026-10-19 Scope: LiPo power/charging design, button controls and menus, accuracy upgrades
    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
2026-10-19 Scope: single integrated PCB with detachable radar heads and SMA link antenna
    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
2026-10-19 Scope: record PCB, antenna, screen and ruggedness decisions
    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
2026-10-19 Build rev A: KiCad 9 schematic + placed PCB and ESP32-S3 pod/display firmware
    Hardware: circuit defined in hardware/design.py, generated into a KiCad 9
    schematic (ERC clean) and placed 4-layer PCB (0 electrical DRC errors,
    0 schematic-parity issues; routing still to do). Netlist is checked
    pin-by-pin against the design and the firmware pin map.
    Firmware: PlatformIO pod/display builds with pure C++ core libraries
    (LD2450 parser, ESP-NOW protocol, tracker, blockage logic, head ID,
    debounce, fuel gauge, geometry) and 55 passing host unit tests.
    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
    [bom.csv, radio-thing.kicad_pcb, radio-thing.kicad_sch]
2026-10-20 Cut display controls to 3 buttons centred under the screen
    UP / OK / DOWN on a 20 mm pitch directly below the display. Holds give the
    missing actions: UP 1.5 s = cycle mode, OK 1.5 s = back, OK 3 s = sleep.
    Debouncer reports hold time (new test). GPIO7/15 freed to test pads.
    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
    [bom.csv, radio-thing.kicad_pcb, radio-thing.kicad_sch]
2026-10-20 Hardware check: datasheet-verified fixes to charger, regulators, sensors, display, buzzer
    Checked every from-memory value against manufacturer datasheets and fixed:
    - BQ24074 ITERM 15k -> 3.0k (was terminating at 50%), ILIM -> ~0.9 A
    - TPS63001 inductor 1.5 -> 2.2 uH, VINA RC filter; TPS61202 COUT 22 uF
    - LIS2MDL C1 220 nF + 10 uF; MAX17048 VDD 100 nF
    - Display (MSP3525/ST7796): powered from switched VSYS, LED pin driven
    directly (it is a logic input), SD_CS pulled high
    - Buzzer from 3V3 through 15 ohm with flyback across the coil
    - DWM3000 IRQ pull-down; 100 ohm series on detachable head UARTs
    - M3 holes on the button tab; In2 freed for power/signal routing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
    [bom.csv, radio-thing.kicad_pcb, radio-thing.kicad_sch]
2026-10-20 Hardware check: routability trial and updated status
    Freerouting trial on the 4-layer board routes ~96% automatically (9 of 243
    connections left), so the placement is routable. Display powered from the
    switched rail so SW1 fully turns it off.
    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
2026-10-24 Route rev A board and add manufacturing outputs
    - Cluster placement: each converter's inductor and caps, the sensors'
    decoupling, USB-C parts, head-ID network and LEDs sit at their IC pins
    - Two-pass Freerouting (route.sh) + GND pours: 938 segments, 108 vias,
    0 unconnected, 0 electrical DRC errors, 0 schematic-parity issues
    - Button tab: routed slots + bridges instead of a V-score (a V-cut would
    sever the button traces)
    - Fixed USB-C orientation-join pattern, 0.35 mm edge keep-outs, solid GND
    on IC thermal pads, 0.3 mm power traces, silkscreen tidy-up
    - Optional DWM3000 footprint moved to rev B (antenna keep-out blocked routing)
    - fab/: Gerber+drill zip, BOM and CPL per build variant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
    [bom-DISPLAY.csv, bom-POD.csv, bom.csv, radio-thing.kicad_pcb, radio-thing.kicad_sch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]
2026-10-24 Add display enclosure + button caps, recentre buttons, build guide
    - enclosure/: parametric OpenSCAD front shell, lid and 3 button caps with
    STLs and previews (screen centred, ribbon to J3, board on lid posts,
    USB-C/power switch/SMA openings, tripod boss, strap slot)
    - PCB: buttons centred on the enclosure centre line (board x 48.8 +/- 17.5),
    wider tab bridges, C5 moved to the MAX17048 VDD side, U3 pin-1 ground
    link; re-routed (932 segments, 107 vias, clean DRC); fab files refreshed
    - route.sh: time-limited third clean-up pass with fallback
    - BUILD-GUIDE.md: what the builder needs to do next
    Claude-Session: https://claude.ai/co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
    [radio-thing.kicad_pcb, radio_thing_caps.stl, radio_thing_display.scad, radio_thing_front.stl, radio_thing_lid.stl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]
